FelipeLeonar2/Felipe_Leonardo_PLC4UNIT/Tarea 6/etiqueta.png

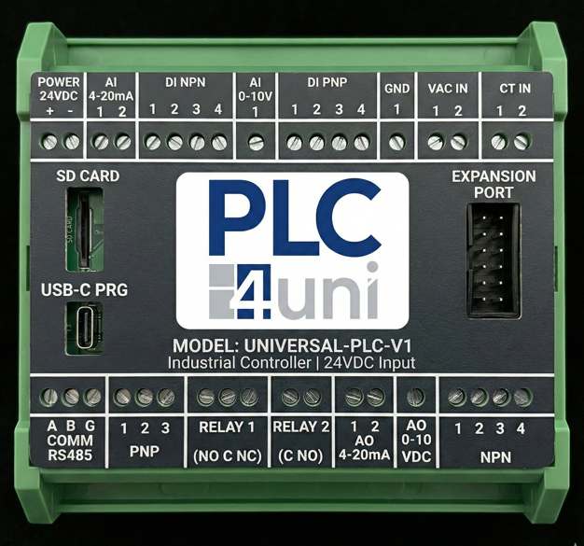
Tarea 6/etiqueta.png
