FelipeLeonar2/Felipe_Leonardo_PLC4UNIT/Tarea 6/Ensamble mejorado.FCStd

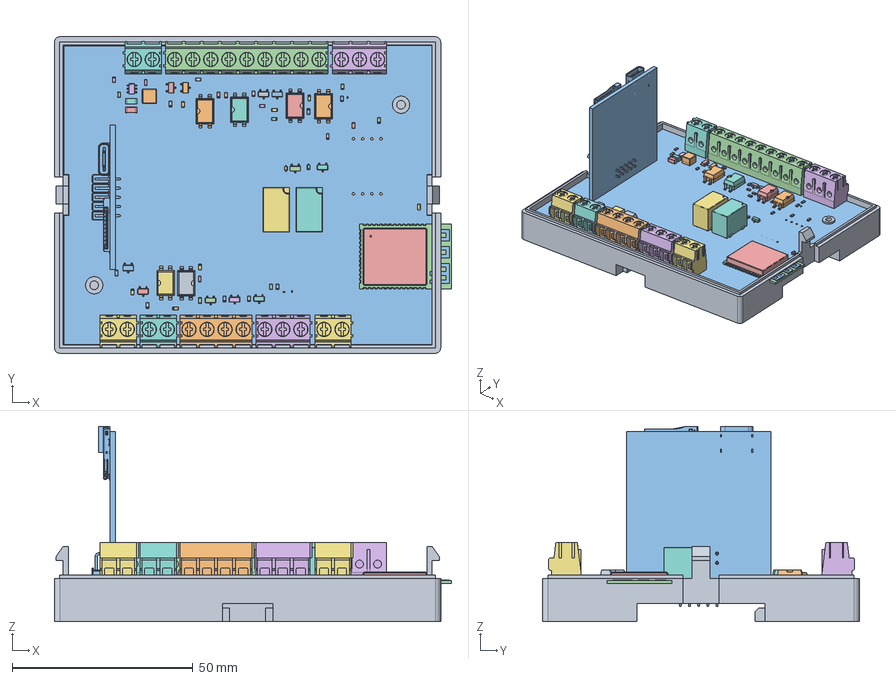
[picture p13: CAD file, 2025-12-11]
Tarea 6/Ensamble mejorado.FCStd
110.0 x 87.7 x 54.1 mm
Carcasa Inferior Felipe
PLC4UNIPCB1_001
Ensamble PCB Vertical1_001
R_0603_1608Metric027
R_0603_1608Metric028
SOT-030
SMDIP-4_W9.53mm006
D_SOD-525
R_0603_1608Metric029
L_APV_ANR4031
SOT-031
TerminalBlock_Phoenix_PT-1,5-9-5.0-H_1x09_P5.00mm_Horizontal001
SMDIP-4_W9.53mm007
C_0603_1608Metric003
C_0603_1608Metric004
TerminalBlock_Phoenix_PT-1,5-2-5.0-H_1x02_P5.00mm_Horizontal004
R_0603_1608Metric030
TerminalBlock_Phoenix_PT-1,5-4-5.0-H_1x04_P5.00mm_Horizontal001
R_0603_1608Metric031
SOT-032
SC-063
C_0201_0603Metric003
R_0603_1608Metric032
Relay_SPDT_Omron_G5V-003
R_0603_1608Metric033
R_0603_1608Metric034
ESP32-S3-WROOM-054
ESP32-S3-WROOM-055
ESP32-S3-WROOM-056
ESP32-S3-WROOM-057
ESP32-S3-WROOM-058
ESP32-S3-WROOM-059
ESP32-S3-WROOM-060
ESP32-S3-WROOM-061
ESP32-S3-WROOM-062
ESP32-S3-WROOM-063
ESP32-S3-WROOM-064
ESP32-S3-WROOM-065
ESP32-S3-WROOM-066
ESP32-S3-WROOM-067
ESP32-S3-WROOM-068
ESP32-S3-WROOM-069
ESP32-S3-WROOM-070
ESP32-S3-WROOM-071
ESP32-S3-WROOM-072
ESP32-S3-WROOM-073
ESP32-S3-WROOM-074
ESP32-S3-WROOM-075
ESP32-S3-WROOM-076
ESP32-S3-WROOM-077
ESP32-S3-WROOM-078
ESP32-S3-WROOM-079
ESP32-S3-WROOM-080
ESP32-S3-WROOM-081
ESP32-S3-WROOM-082
ESP32-S3-WROOM-083
ESP32-S3-WROOM-084
ESP32-S3-WROOM-085
ESP32-S3-WROOM-086
ESP32-S3-WROOM-087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
