FelipeLeonar2/Felipe_Leonardo_PLC4UNIT/Tarea 4/Ensamble PCB Vertical.STEP

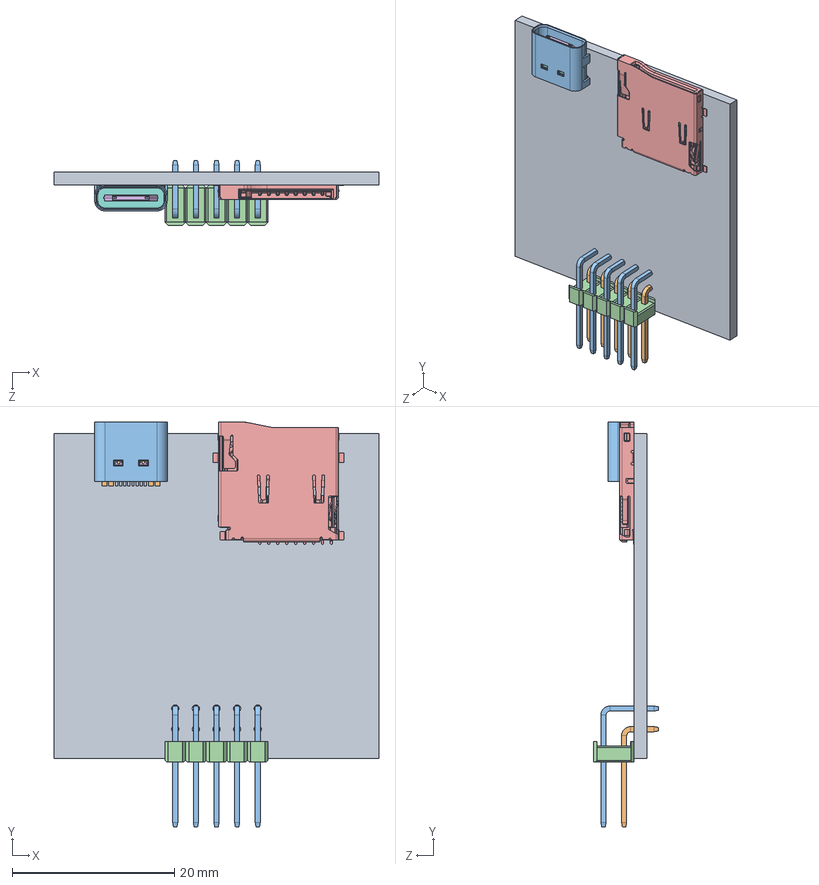
[picture p15: CAD file, 2025-12-04]
Tarea 4/Ensamble PCB Vertical.STEP
40.0 x 49.9 x 8.00 mm
PCB Vertical
2x5 Male Pin Header Angle
Same_Sky_MSD-4-A
USB Type C Port (SMD Type) (1)[1]
