FelipeLeonar2/Felipe_Leonardo_PLC4UNIT/Tarea 2/FreeCAD/Carcasa inferior 001 Felipe Leonardo 2021-1833.FCStd

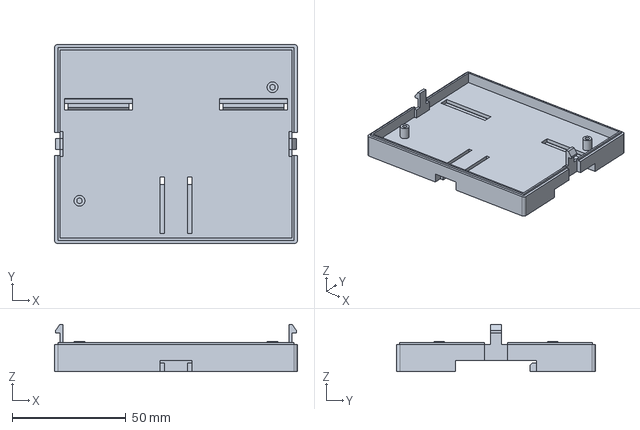
[picture p16: CAD file, 2025-10-09]
Tarea 2/FreeCAD/Carcasa inferior 001 Felipe Leonardo 2021-1833.FCStd
107.0 x 87.7 x 20.8 mm
