FelipeLeonar2/Felipe_Leonardo_PLC4UNIT/Tarea 3/2D ARCHIVO DXF/PLC4UNI-SUPERIOR-000.dxf

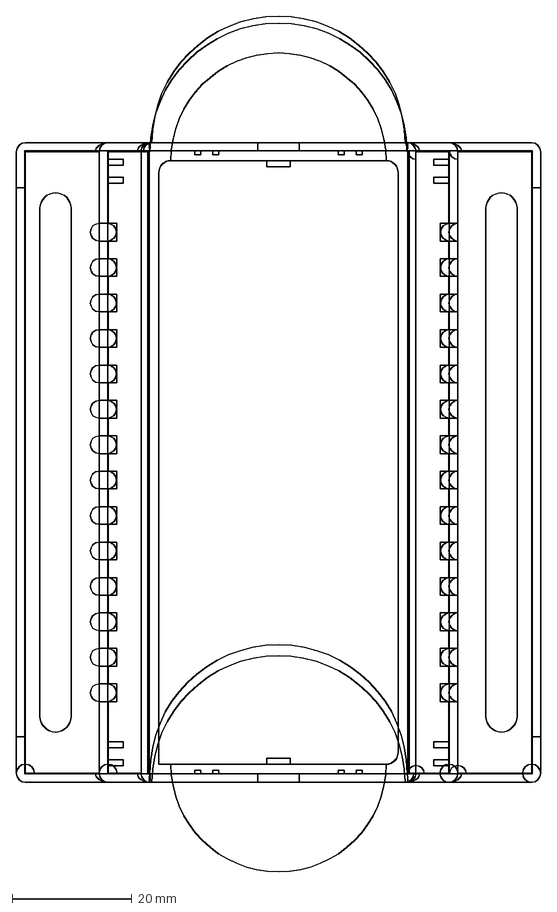
[picture p17: CAD file, 2025-10-10]
Tarea 3/2D ARCHIVO DXF/PLC4UNI-SUPERIOR-000.dxf
87.7 x 143.2 mm
