FelipeLeonar2/Felipe_Leonardo_PLC4UNIT/Tarea 4/2x5 Male Pin Header Angle.STEP

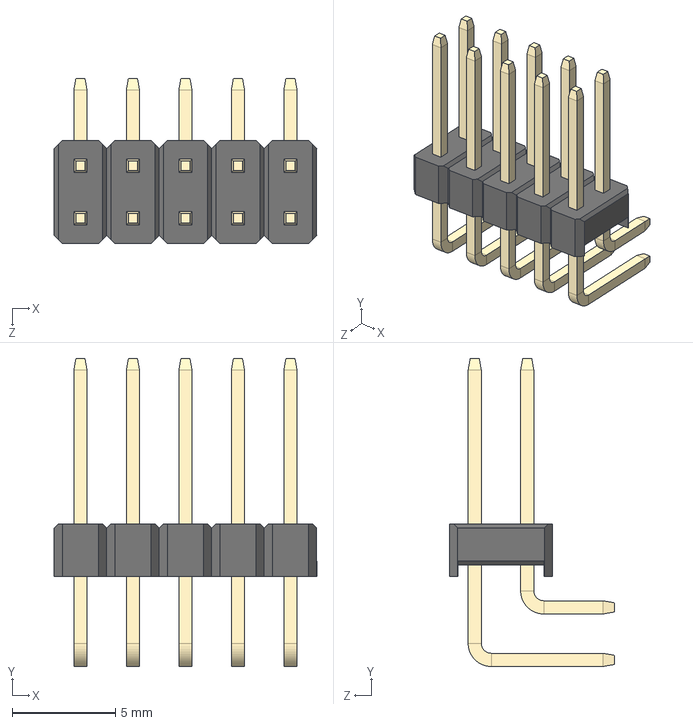
[picture p18: CAD file, 2025-12-04]
Tarea 4/2x5 Male Pin Header Angle.STEP
12.7 x 14.9 x 8.00 mm
