FelipeLeonar2/Felipe_Leonardo_PLC4UNIT/Tarea 2/FreeCAD/Carcasa Superor 000 Felipe Leonardo 2021-1833.FCStd

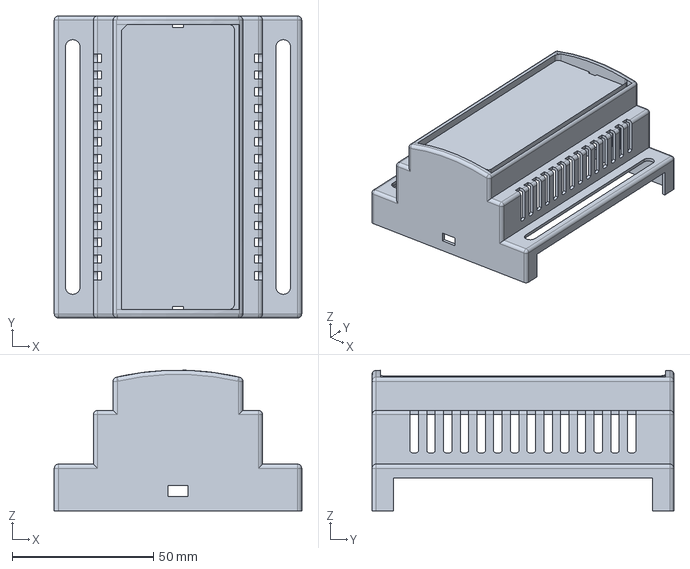
[picture p19: CAD file, 2025-10-09]
Tarea 2/FreeCAD/Carcasa Superor 000 Felipe Leonardo 2021-1833.FCStd
87.7 x 107.0 x 49.8 mm
