FelipeLeonar2/Felipe_Leonardo_PLC4UNIT/Tarea 3/2D ARCHIVO DXF/PLC4UNI-INFERIOR-001.dxf

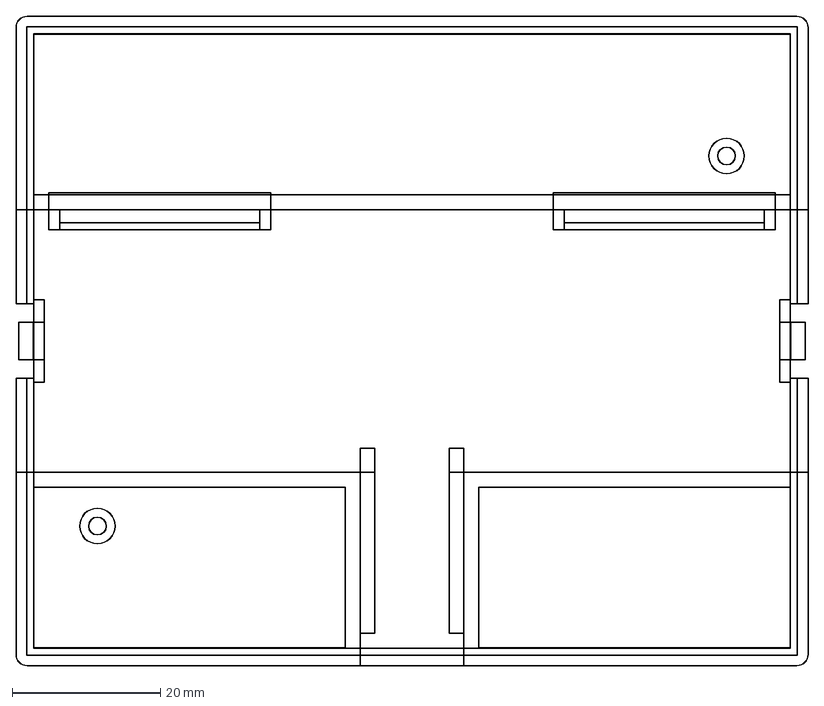
[picture p20: CAD file, 2025-10-10]
Tarea 3/2D ARCHIVO DXF/PLC4UNI-INFERIOR-001.dxf
107.0 x 87.7 mm
