FelipeLeonar2/Felipe_Leonardo_PLC4UNIT/Tarea 4/PCB Vertical.DXF

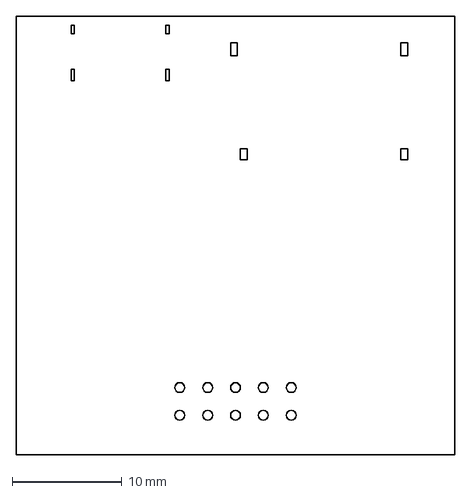
[picture p21: CAD file, 2025-12-04]
Tarea 4/PCB Vertical.DXF
40.0 x 40.0 mm
