FelipeLeonar2/Felipe_Leonardo_PLC4UNIT/Tarea 4/Same_Sky_MSD-4-A.step

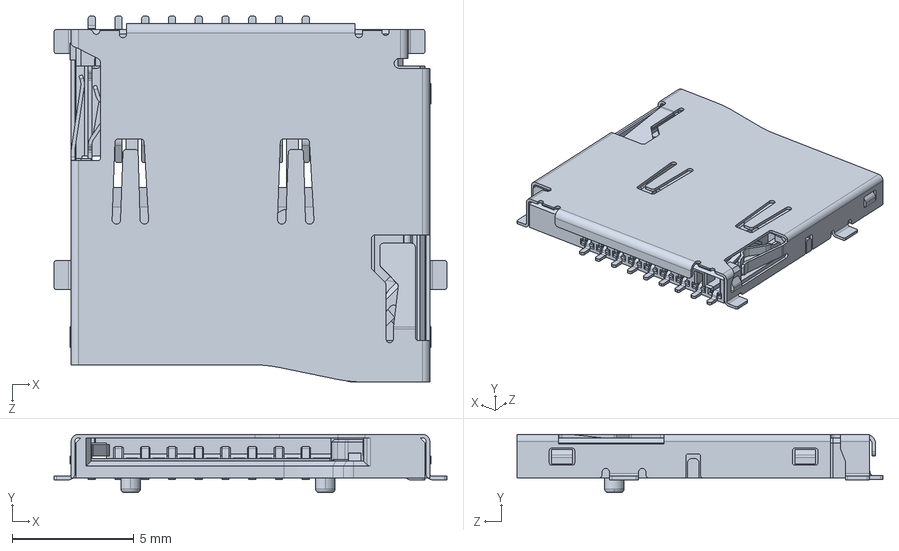
[picture p22: CAD file, 2025-12-04]
Tarea 4/Same_Sky_MSD-4-A.step
16.1 x 2.40 x 15.0 mm
