FelipeLeonar2/Felipe_Leonardo_PLC4UNIT/Tarea 4/USB Type C Port (SMD Type) (1)[1].STEP

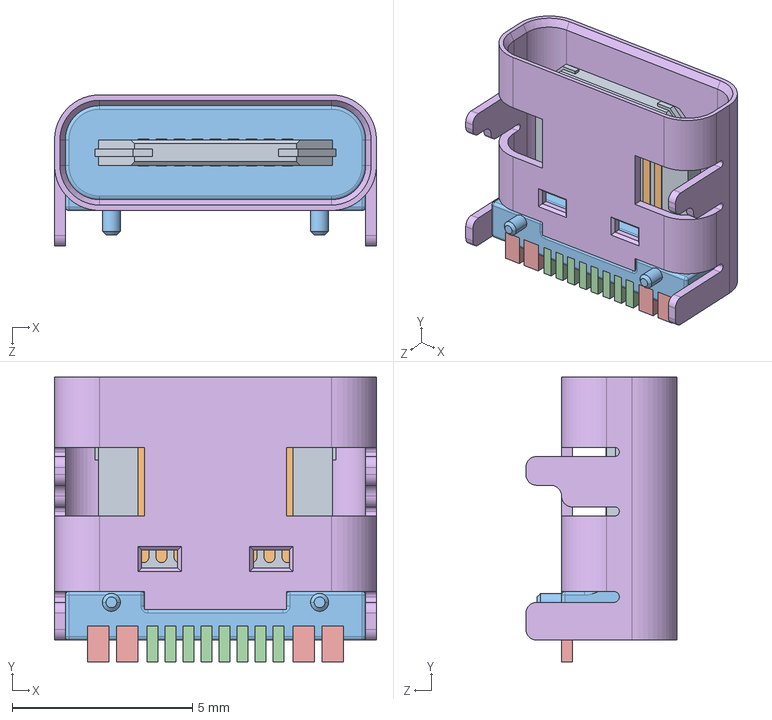
[picture p23: CAD file, 2025-12-04]
Tarea 4/USB Type C Port (SMD Type) (1)[1].STEP
8.94 x 7.90 x 4.20 mm
