FelipeLeonar2/Felipe_Leonardo_PLC4UNIT/PLC4Uni FelipeLG/PLC4Uni FelipeLG.kicad_pcb

## KiCad design PLC4Uni FelipeLG/PLC4Uni FelipeLG.kicad_pcb (2025-12-11)

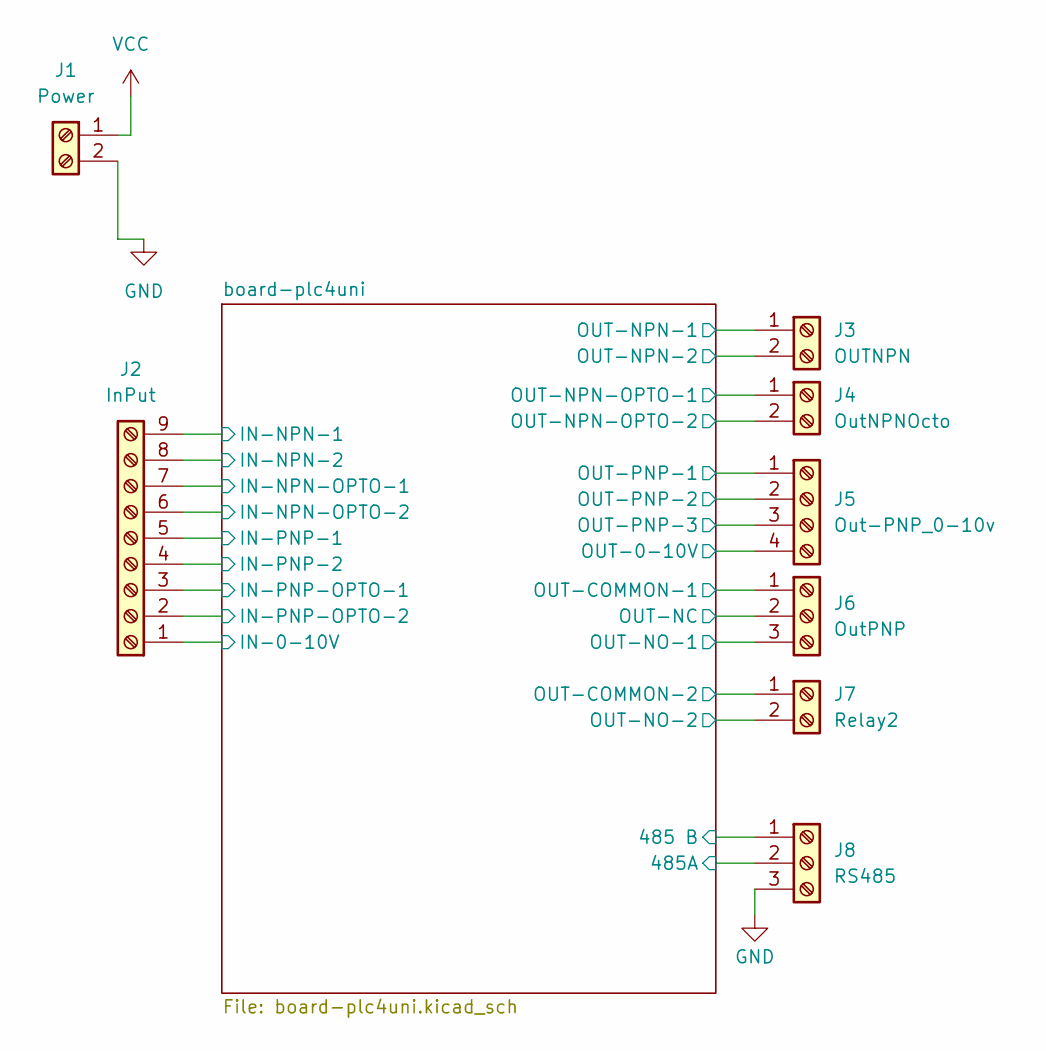
[picture p25: schematic PLC4Uni FelipeLG.kicad_sch]

Parts:
J1: Power; TerminalBlock_Phoenix_PT-1,5-2-5.0-H_1x02_P5.00mm_Horizontal
J2: InPut; TerminalBlock_Phoenix_PT-1,5-9-5.0-H_1x09_P5.00mm_Horizontal
J3: OUTNPN; TerminalBlock_Phoenix_PT-1,5-2-5.0-H_1x02_P5.00mm_Horizontal
J4: OutNPNOcto; TerminalBlock_Phoenix_PT-1,5-2-5.0-H_1x02_P5.00mm_Horizontal
J5: Out-PNP_0-10v; TerminalBlock_Phoenix_PT-1,5-4-5.0-H_1x04_P5.00mm_Horizontal
J6: OutPNP; TerminalBlock_Phoenix_PT-1,5-3-5.0-H_1x03_P5.00mm_Horizontal
J7: Relay2; TerminalBlock_Phoenix_PT-1,5-2-5.0-H_1x02_P5.00mm_Horizontal
J8: RS485; TerminalBlock_Phoenix_PT-1,5-3-5.0-H_1x03_P5.00mm_Horizontal

Connections:
/board-plc4uni/485 B: J8.1; also elsewhere on the board
/board-plc4uni/485A: J8.2; also elsewhere on the board
/board-plc4uni/IN-0-10V: J2.1; also elsewhere on the board
/board-plc4uni/IN-NPN-1: J2.9; also elsewhere on the board
/board-plc4uni/IN-NPN-2: J2.8; also elsewhere on the board
/board-plc4uni/IN-NPN-OPTO-1: J2.7; also elsewhere on the board
/board-plc4uni/IN-NPN-OPTO-2: J2.6; also elsewhere on the board
/board-plc4uni/IN-PNP-1: J2.5; also elsewhere on the board
/board-plc4uni/IN-PNP-2: J2.4; also elsewhere on the board
/board-plc4uni/IN-PNP-OPTO-1: J2.3; also elsewhere on the board
/board-plc4uni/IN-PNP-OPTO-2: J2.2; also elsewhere on the board
/board-plc4uni/OUT-0-10V: J5.4; also elsewhere on the board
/board-plc4uni/OUT-COMMON-1: J6.1; also elsewhere on the board
/board-plc4uni/OUT-COMMON-2: J7.1; also elsewhere on the board
/board-plc4uni/OUT-NC: J6.2; also elsewhere on the board
/board-plc4uni/OUT-NO-1: J6.3; also elsewhere on the board
/board-plc4uni/OUT-NO-2: J7.2; also elsewhere on the board
/board-plc4uni/OUT-NPN-1: J3.1; also elsewhere on the board
/board-plc4uni/OUT-NPN-2: J3.2; also elsewhere on the board
/board-plc4uni/OUT-NPN-OPTO-1: J4.1; also elsewhere on the board
/board-plc4uni/OUT-NPN-OPTO-2: J4.2; also elsewhere on the board
/board-plc4uni/OUT-PNP-1: J5.1; also elsewhere on the board
/board-plc4uni/OUT-PNP-2: J5.2; also elsewhere on the board
/board-plc4uni/OUT-PNP-3: J5.3; also elsewhere on the board
GND: J1.2, J8.3; also elsewhere on the board
VCC: J1.1; also elsewhere on the board

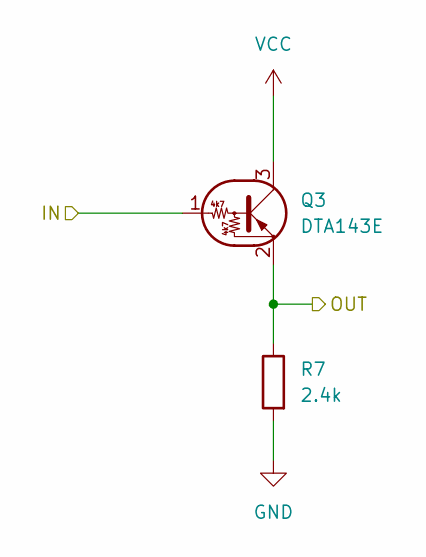
[picture p26: schematic OUT-NPN-1.kicad_sch]

Parts:
Q3: DTA143E; SC-59
R7: 2.4k; R_0603_1608Metric

Connections:
/board-plc4uni/OUT-NPN-2: Q3.2 (E), R7.2; also elsewhere on the board
/board-plc4uni/OUT-NPN-2/IN: Q3.1 (B); also elsewhere on the board
GND: R7.1; also elsewhere on the board
VCC: Q3.3 (C); also elsewhere on the board

Parts of its further copies:
Q7: DTA143E; SC-59
R21: 2.4k; R_0603_1608Metric

Connections of its further copies:
/board-plc4uni/OUT-NPN-1: Q7.2 (E), R21.2; also elsewhere on the board
/board-plc4uni/OUT-NPN-1/IN: Q7.1 (B); also elsewhere on the board
GND: R21.1; also elsewhere on the board
VCC: Q7.3 (C); also elsewhere on the board

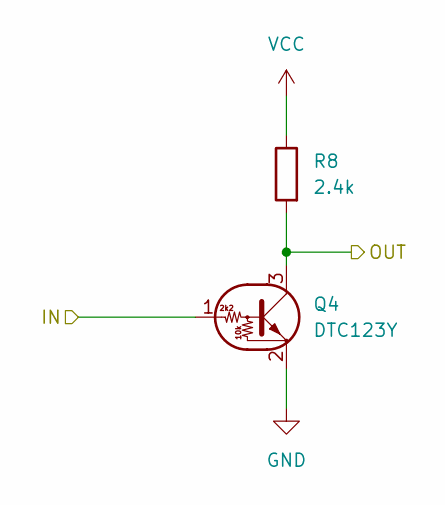
[picture p27: schematic output-pnp.kicad_sch]

Parts:
Q4: DTC123Y; SOT-23
R8: 2.4k; R_0603_1608Metric

Connections:
/board-plc4uni/OUT-PNP-1: Q4.3 (C), R8.1; also elsewhere on the board
/board-plc4uni/output-pnp-1/IN: Q4.1 (B); also elsewhere on the board
GND: Q4.2 (E); also elsewhere on the board
VCC: R8.2; also elsewhere on the board

Parts of its further copies:
Q8, Q9: DTC123Y; SOT-23
R22, R23: 2.4k; R_0603_1608Metric

Connections of its further copies:
/board-plc4uni/OUT-PNP-2: Q8.3 (C), R22.1; also elsewhere on the board
/board-plc4uni/OUT-PNP-3: Q9.3 (C), R23.1; also elsewhere on the board
/board-plc4uni/output-pnp-2/IN: Q8.1 (B); also elsewhere on the board
/board-plc4uni/output-pnp-3/IN: Q9.1 (B); also elsewhere on the board
GND: Q8.2 (E), Q9.2 (E); also elsewhere on the board
VCC: R22.2, R23.2; also elsewhere on the board

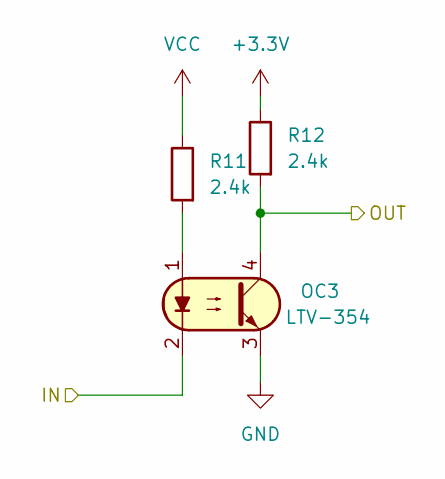
[picture p28: schematic input-pnp-opto.kicad_sch]

Parts:
OC3: FOD817S; SMDIP-4_W9.53mm; Part Number LTV-354
R11, R12: 2.4k; R_0603_1608Metric

Connections:
+3.3V: R12.2; also elsewhere on the board
/board-plc4uni/IN-PNP-OPTO-1: OC3.2; also elsewhere on the board
/board-plc4uni/input-pnp-opto-1/OUT: OC3.4, R12.1; also elsewhere on the board
GND: OC3.3; also elsewhere on the board
unnamed: OC3.1, R11.1
VCC: R11.2; also elsewhere on the board

Parts of its further copies:
OC5: FOD817S; SMDIP-4_W9.53mm; Part Number LTV-354
R16, R17: 2.4k; R_0603_1608Metric

Connections of its further copies:
+3.3V: R17.2; also elsewhere on the board
/board-plc4uni/IN-PNP-OPTO-2: OC5.2; also elsewhere on the board
/board-plc4uni/input-pnp-opto-2/OUT: OC5.4, R17.1; also elsewhere on the board
GND: OC5.3; also elsewhere on the board
unnamed: OC5.1, R16.1
VCC: R16.2; also elsewhere on the board

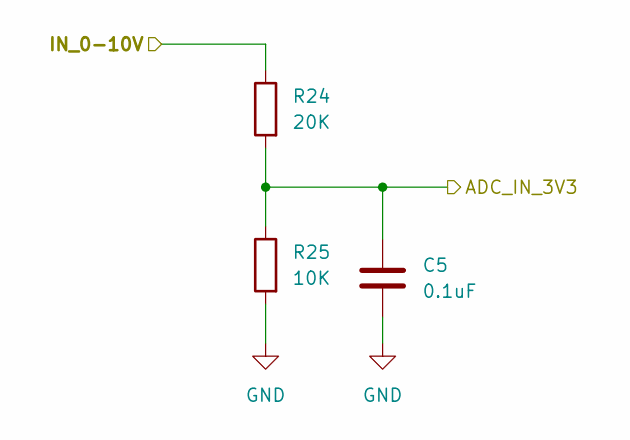
[picture p29: schematic INPUT-0-10V.kicad_sch]

Parts:
C5: 0.1uF; C_0201_0603Metric; LCSC C66501
R24: 20K; R_0603_1608Metric
R25: 10K; R_0603_1608Metric

Connections:
/board-plc4uni/IN-0-10V: R24.2; also elsewhere on the board
/board-plc4uni/INPUT-0-10V/ADC_IN_3V3: C5.2, R24.1, R25.2; also elsewhere on the board
GND: C5.1, R25.1; also elsewhere on the board

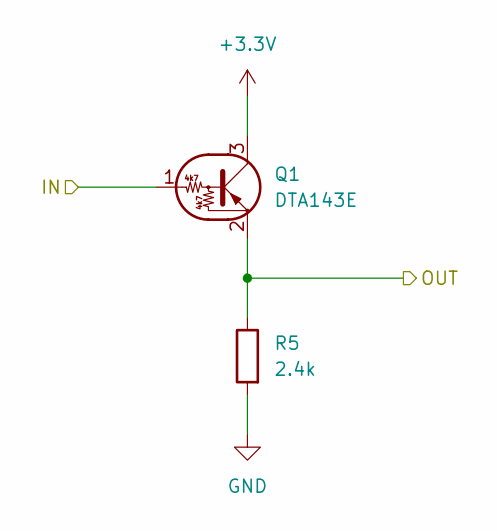
[picture p30: schematic input-npn.kicad_sch]

Parts:
Q1: DTA143E; SC-59
R5: 2.4k; R_0603_1608Metric

Connections:
+3.3V: Q1.3 (C); also elsewhere on the board
/board-plc4uni/IN-NPN-1: Q1.1 (B); also elsewhere on the board
/board-plc4uni/input-npn-1/OUT: Q1.2 (E), R5.2; also elsewhere on the board
GND: R5.1; also elsewhere on the board

Parts of its further copies:
Q5: DTA143E; SC-59
R15: 2.4k; R_0603_1608Metric

Connections of its further copies:
+3.3V: Q5.3 (C); also elsewhere on the board
/board-plc4uni/IN-NPN-2: Q5.1 (B); also elsewhere on the board
/board-plc4uni/input-npn-2/OUT: Q5.2 (E), R15.2; also elsewhere on the board
GND: R15.1; also elsewhere on the board

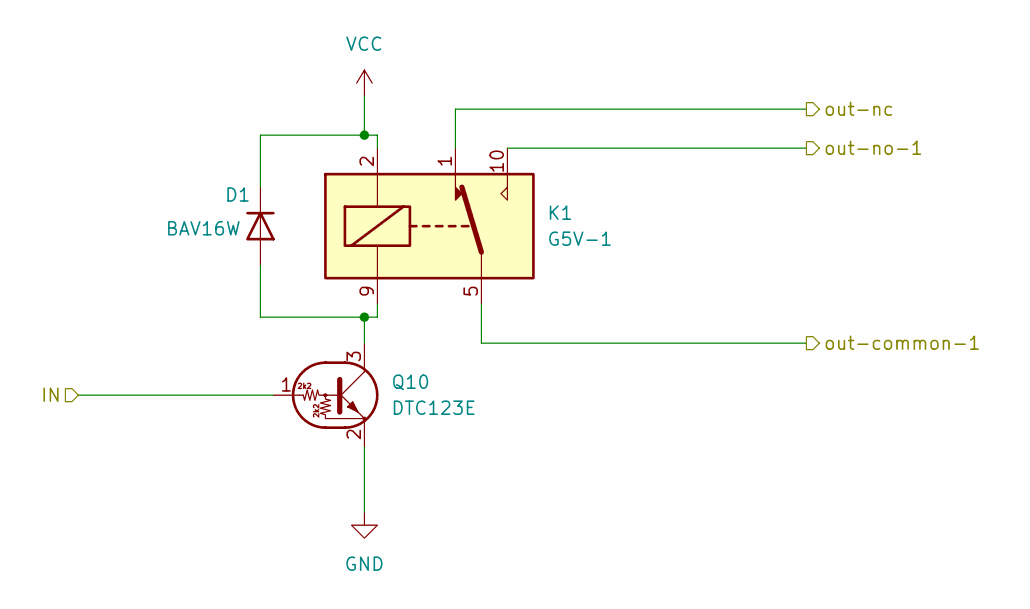
[picture p31: schematic OUT-RELAY-1.kicad_sch]

Parts:
D1: 1N4148WT; D_SOD-523; Part number BAV16W
K1: G5V-1; Relay_SPDT_Omron_G5V-1
Q10: DTC123E; SOT-23

Connections:
/board-plc4uni/OUT-COMMON-1: K1.5, K1.6; also elsewhere on the board
/board-plc4uni/OUT-NC: K1.1; also elsewhere on the board
/board-plc4uni/OUT-NO-1: K1.10; also elsewhere on the board
/board-plc4uni/OUT-RELAY-1/IN: Q10.1 (B); also elsewhere on the board
GND: Q10.2 (E); also elsewhere on the board
unnamed: D1.2 (A), K1.9, Q10.3 (C)
VCC: D1.1 (K), K1.2; also elsewhere on the board

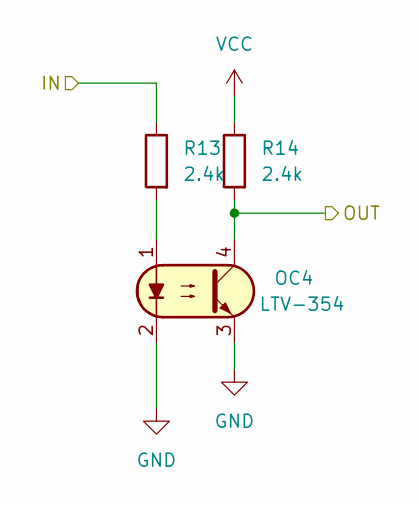
[picture p32: schematic output-npn-opto.kicad_sch]

Parts:
OC4: FOD817S; SMDIP-4_W9.53mm; Part Number LTV-354
R13, R14: 2.4k; R_0603_1608Metric

Connections:
/board-plc4uni/OUT-NPN-OPTO-1: OC4.4, R14.1; also elsewhere on the board
/board-plc4uni/output-npn-opto-1/IN: R13.2; also elsewhere on the board
GND: OC4.2, OC4.3; also elsewhere on the board
unnamed: OC4.1, R13.1
VCC: R14.2; also elsewhere on the board

Parts of its further copies:
OC6: FOD817S; SMDIP-4_W9.53mm; Part Number LTV-354
R19, R20: 2.4k; R_0603_1608Metric

Connections of its further copies:
/board-plc4uni/OUT-NPN-OPTO-2: OC6.4, R20.1; also elsewhere on the board
/board-plc4uni/output-npn-opto-2/IN: R19.2; also elsewhere on the board
GND: OC6.2, OC6.3; also elsewhere on the board
unnamed: OC6.1, R19.1
VCC: R20.2; also elsewhere on the board

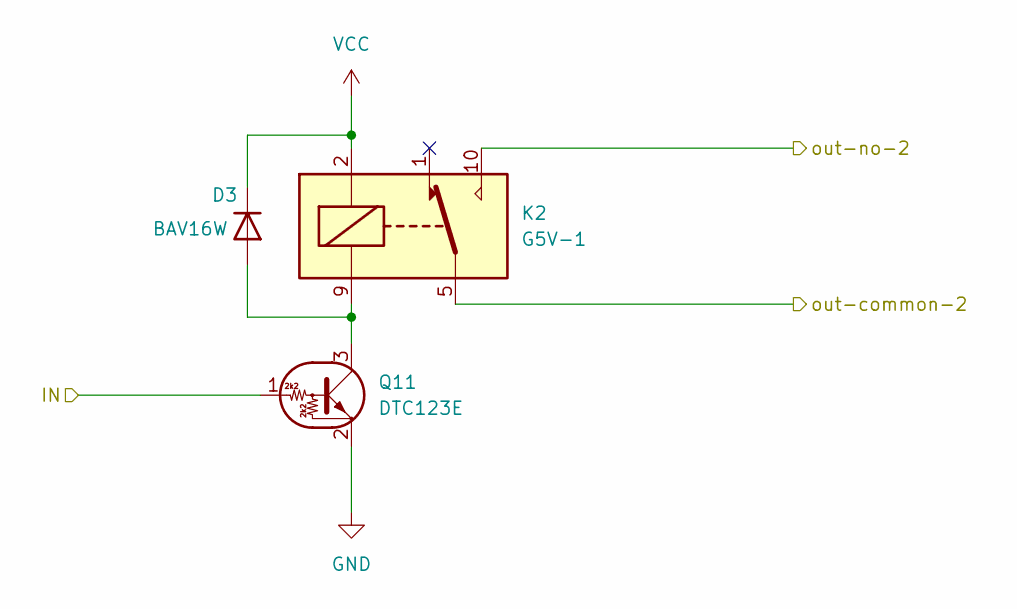
[picture p33: schematic OUT-RELAY-2.kicad_sch]

Parts:
D3: 1N4148WT; D_SOD-523; Part number BAV16W
K2: G5V-1; Relay_SPDT_Omron_G5V-1
Q11: DTC123E; SOT-23

Connections:
/board-plc4uni/OUT-COMMON-2: K2.5, K2.6; also elsewhere on the board
/board-plc4uni/OUT-NO-2: K2.10; also elsewhere on the board
/board-plc4uni/OUT-RELAY-2/IN: Q11.1 (B); also elsewhere on the board
GND: Q11.2 (E); also elsewhere on the board
unnamed: D3.2 (A), K2.9, Q11.3 (C)
VCC: D3.1 (K), K2.2; also elsewhere on the board

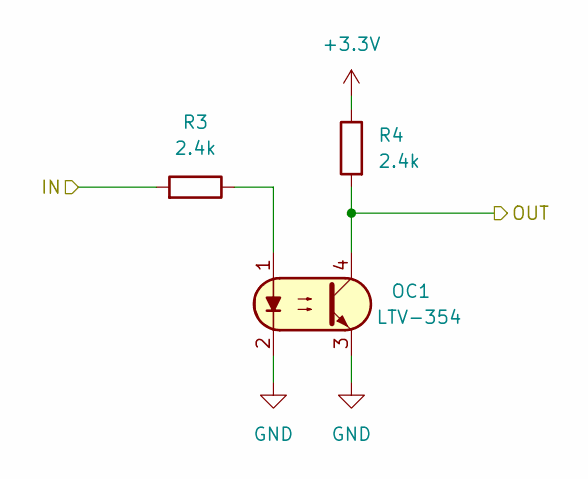
[picture p34: schematic input-npn-opto.kicad_sch]

Parts:
OC1: FOD817S; SMDIP-4_W9.53mm; Part Number LTV-354
R3, R4: 2.4k; R_0603_1608Metric

Connections:
+3.3V: R4.2; also elsewhere on the board
/board-plc4uni/IN-NPN-OPTO-2: R3.1; also elsewhere on the board
/board-plc4uni/input-npn-opto-2/OUT: OC1.4, R4.1; also elsewhere on the board
GND: OC1.2, OC1.3; also elsewhere on the board
unnamed: OC1.1, R3.2

Parts of its further copies:
OC2: FOD817S; SMDIP-4_W9.53mm; Part Number LTV-354
R9, R10: 2.4k; R_0603_1608Metric

Connections of its further copies:
+3.3V: R10.2; also elsewhere on the board
/board-plc4uni/IN-NPN-OPTO-1: R9.1; also elsewhere on the board
/board-plc4uni/input-npn-opto-1/OUT: OC2.4, R10.1; also elsewhere on the board
GND: OC2.2, OC2.3; also elsewhere on the board
unnamed: OC2.1, R9.2

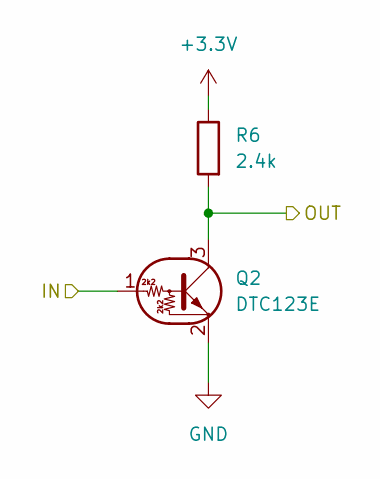
[picture p35: schematic input-pnp.kicad_sch]

Parts:
Q2: DTC123E; SOT-23
R6: 2.4k; R_0603_1608Metric

Connections:
+3.3V: R6.2; also elsewhere on the board
/board-plc4uni/IN-PNP-1: Q2.1 (B); also elsewhere on the board
/board-plc4uni/input-pnp-1/OUT: Q2.3 (C), R6.1; also elsewhere on the board
GND: Q2.2 (E); also elsewhere on the board

Parts of its further copies:
Q6: DTC123E; SOT-23
R18: 2.4k; R_0603_1608Metric

Connections of its further copies:
+3.3V: R18.2; also elsewhere on the board
/board-plc4uni/IN-PNP-2: Q6.1 (B); also elsewhere on the board
/board-plc4uni/input-pnp-2/OUT: Q6.3 (C), R18.1; also elsewhere on the board
GND: Q6.2 (E); also elsewhere on the board

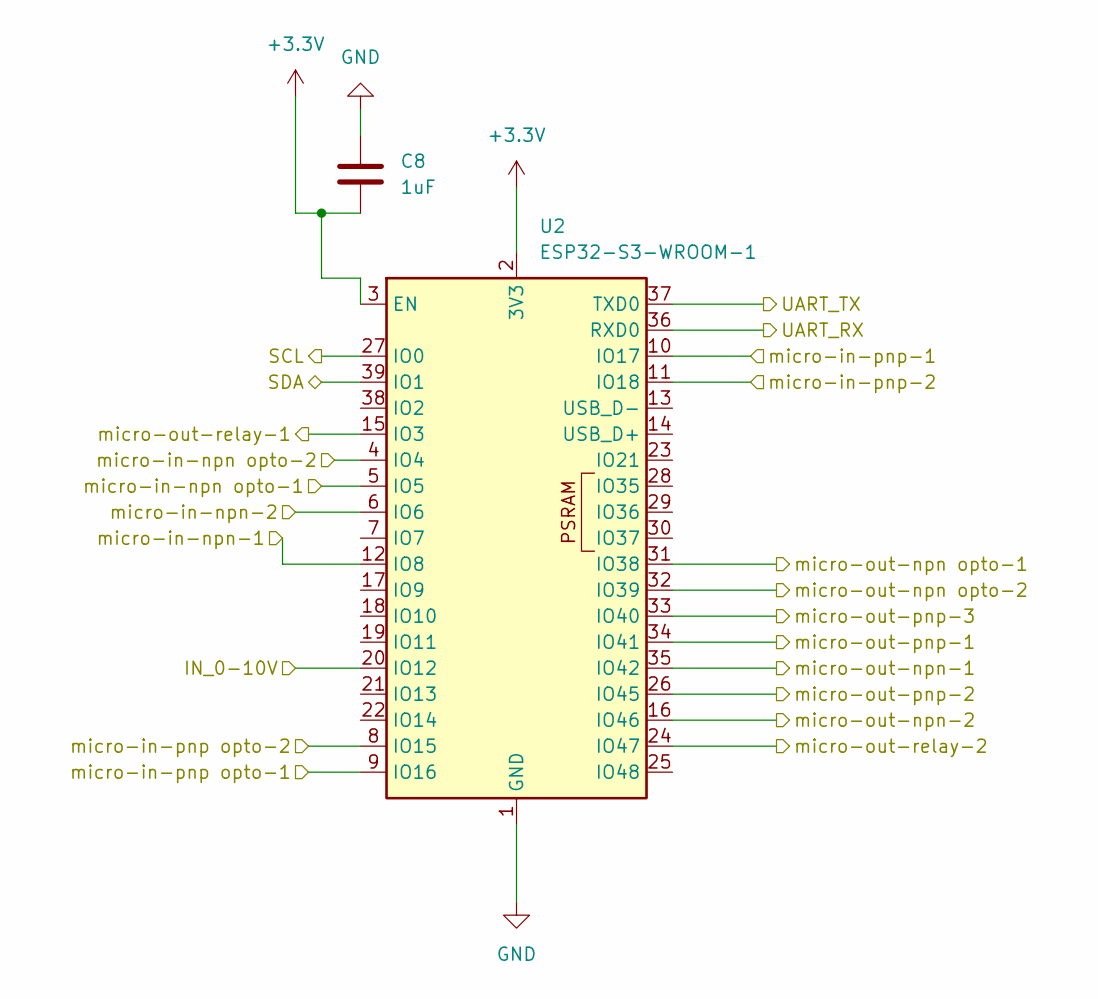
[picture p36: schematic plc4uni-cpu.kicad_sch]

Parts:
C8: 1uF; C_0603_1608Metric; LCSC C89632
U2: ESP32-S3-WROOM-1

Connections:
+3.3V: C8.2, U2.2 (3V3), U2.3 (EN); also elsewhere on the board
/board-plc4uni/INPUT-0-10V/ADC_IN_3V3: U2.20 (IO12); also elsewhere on the board
/board-plc4uni/OUT-NPN-1/IN: U2.35 (IO42); also elsewhere on the board
/board-plc4uni/OUT-NPN-2/IN: U2.16 (IO46); also elsewhere on the board
/board-plc4uni/OUT-RELAY-1/IN: U2.15 (IO3); also elsewhere on the board
/board-plc4uni/OUT-RELAY-2/IN: U2.24 (IO47); also elsewhere on the board
/board-plc4uni/OUTPUT-0-10V/SCL: U2.27 (IO0); also elsewhere on the board
/board-plc4uni/OUTPUT-0-10V/SDA: U2.39 (IO1); also elsewhere on the board
/board-plc4uni/RS485/UART_RX: U2.36 (RXD0); also elsewhere on the board
/board-plc4uni/RS485/UART_TX: U2.37 (TXD0); also elsewhere on the board
/board-plc4uni/input-npn-1/OUT: U2.12 (IO8); also elsewhere on the board
/board-plc4uni/input-npn-2/OUT: U2.6 (IO6); also elsewhere on the board
/board-plc4uni/input-npn-opto-1/OUT: U2.5 (IO5); also elsewhere on the board
/board-plc4uni/input-npn-opto-2/OUT: U2.4 (IO4); also elsewhere on the board
/board-plc4uni/input-pnp-1/OUT: U2.10 (IO17); also elsewhere on the board
/board-plc4uni/input-pnp-2/OUT: U2.11 (IO18); also elsewhere on the board
/board-plc4uni/input-pnp-opto-1/OUT: U2.9 (IO16); also elsewhere on the board
/board-plc4uni/input-pnp-opto-2/OUT: U2.8 (IO15); also elsewhere on the board
/board-plc4uni/output-npn-opto-1/IN: U2.31 (IO38); also elsewhere on the board
/board-plc4uni/output-npn-opto-2/IN: U2.32 (IO39); also elsewhere on the board
/board-plc4uni/output-pnp-1/IN: U2.34 (IO41); also elsewhere on the board
/board-plc4uni/output-pnp-2/IN: U2.26 (IO45); also elsewhere on the board
/board-plc4uni/output-pnp-3/IN: U2.33 (IO40); also elsewhere on the board
GND: C8.1, U2.1 (GND), U2.40 (GND), U2.41 (GND); also elsewhere on the board

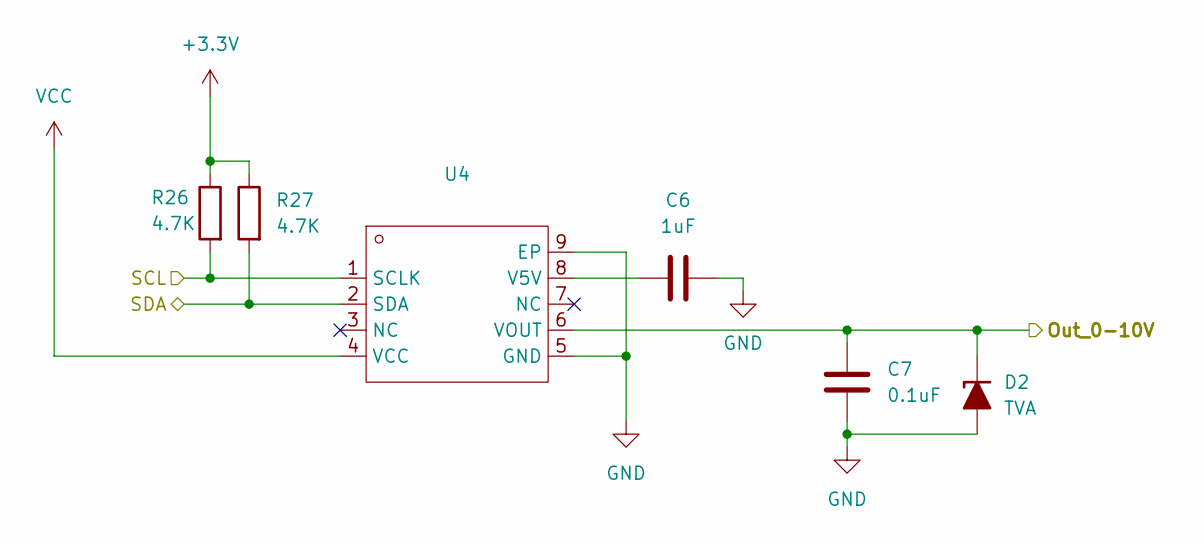
[picture p37: schematic OUTPUT-0-10V.kicad_sch]

Parts:
C6: 1uF; C_0201_0603Metric; LCSC C1592
C7: 0.1uF; C_0201_0603Metric; LCSC C66501
D2: TVA; D_0201_0603Metric_TVS; LCSC C18199535
R26, R27: 4.7K; R_0603_1608Metric
U4: Sensirion_DFN-8-1EP_2.5x2.5mm_P0.5mm_EP1.1x1.7mm; LCSC C3152008

Connections:
+3.3V: R26.2, R27.2; also elsewhere on the board
/board-plc4uni/OUT-0-10V: C7.2, D2.1 (K), U4.6 (VOUT); also elsewhere on the board
/board-plc4uni/OUTPUT-0-10V/SCL: R26.1, U4.1 (SCLK); also elsewhere on the board
/board-plc4uni/OUTPUT-0-10V/SDA: R27.1, U4.2 (SDA); also elsewhere on the board
GND: C6.2, C7.1, D2.2 (A), U4.5 (GND), U4.9 (EP); also elsewhere on the board
unnamed: C6.1, U4.8 (V5V)
VCC: U4.4 (VCC); also elsewhere on the board

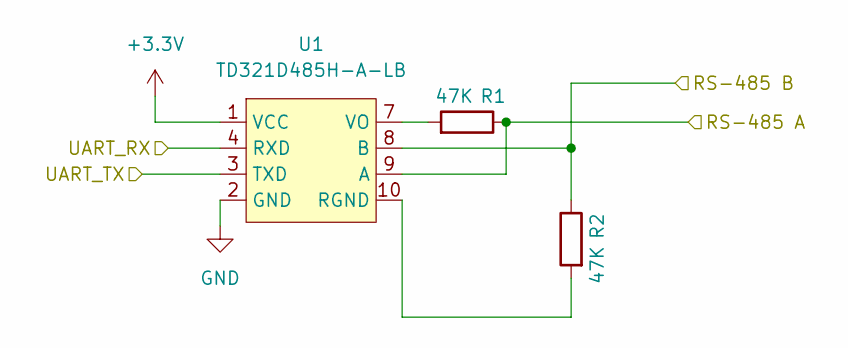
[picture p38: schematic RS485.kicad_sch]

Parts:
R1, R2: 47K; R_0603_1608Metric
U1: TD321D485H-A-LB; TD321D48H-A

Connections:
+3.3V: U1.1 (VCC); also elsewhere on the board
/board-plc4uni/485 B: R2.2, U1.8 (B); also elsewhere on the board
/board-plc4uni/485A: R1.2, U1.9 (A); also elsewhere on the board
/board-plc4uni/RS485/UART_RX: U1.4 (RXD); also elsewhere on the board
/board-plc4uni/RS485/UART_TX: U1.3 (TXD); also elsewhere on the board
GND: U1.2 (GND); also elsewhere on the board
unnamed: R2.1, U1.10 (RGND)
unnamed: R1.1, U1.7 (VO)

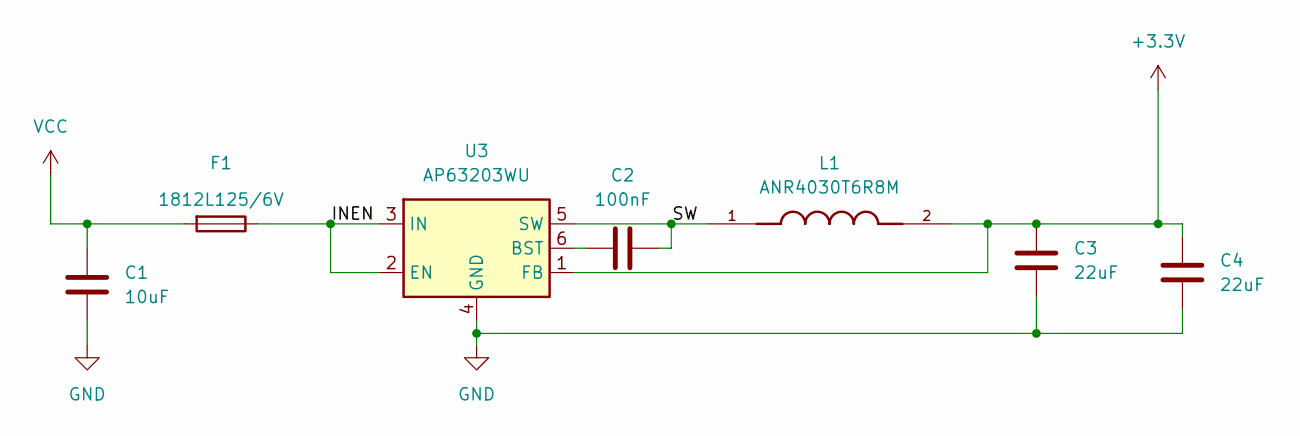
[picture p39: schematic source protection.kicad_sch]

Parts:
C1: 10uF; C_0603_1608Metric; LCSC C89632
C2: 100nF; C_0603_1608Metric; LCSC C519980
C3, C4: 22uF; C_1206_3216Metric; LCSC C7472972
F1: Fuse; Fuse_0603_1608Metric; Part number 1812L125/6V
L1: ANR4030T6R8M; L_APV_ANR4030; LCSC C77758
U3: AP63203WU; TSOT-23-6

Connections:
+3.3V: C3.1, C4.1, L1.2, U3.1 (FB); also elsewhere on the board
/board-plc4uni/source protection/INEN: F1.1, U3.2 (EN), U3.3 (IN)
/board-plc4uni/source protection/SW: C2.2, L1.1, U3.5 (SW)
GND: C1.2, C3.2, C4.2, U3.4 (GND); also elsewhere on the board
unnamed: C2.1, U3.6 (BST)
VCC: C1.1, F1.2; also elsewhere on the board

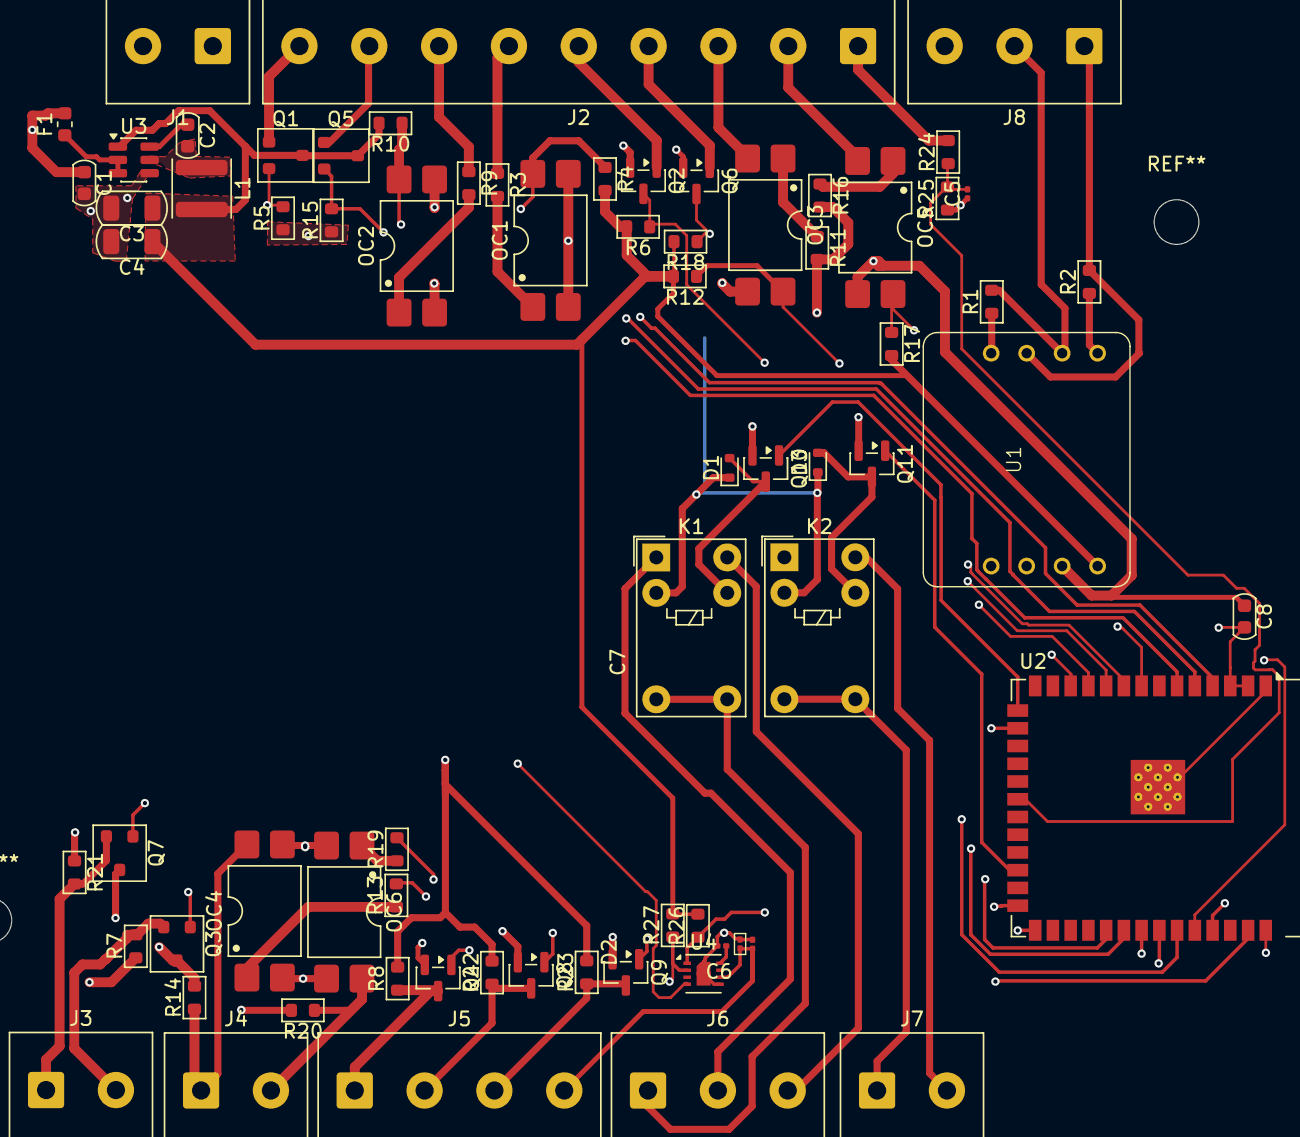
[picture p40: board PLC4Uni FelipeLG.kicad_pcb from above]

Board: 4 copper layers, 71 parts (0 on the bottom side), 63 nets.
