FelipeLeonar2/Felipe_Leonardo_PLC4UNIT/(commit log)

2025-10-06 Diseños 3D de la carcasa para el PLC
2025-10-09 Tarea 2
    [Carcasa Superor 000 Felipe Leonardo 2021-1833.FCStd, Carcasa inferior 001 Felipe Leonardo 2021-1833.FCStd]
2025-10-10 Tarea 3 agregada
    [PLC4UNI-INFERIOR-001.dxf, PLC4UNI-SUPERIOR-000.dxf, PLC4uni.kicad_pcb, PLC4uni.kicad_sch]
2025-11-20 Add files via upload
    Se agregaron los circuitos del PLC
    [INPUT-0-10V.kicad_sch, OUT-NPN-1.kicad_sch, OUT-RELAY-1.kicad_sch, OUT-RELAY-2.kicad_sch, OUTPUT-0-10V.kicad_sch, PLC4Uni FelipeLG.kicad_pcb, PLC4Uni FelipeLG.kicad_sch, RS485.kicad_sch]
2025-12-04 Add files via upload
    Updated Circuitos corregidos y pistas agregadas
    [INPUT-0-10V.kicad_sch, OUT-NPN-1.kicad_sch, OUT-RELAY-1.kicad_sch, OUT-RELAY-2.kicad_sch, OUTPUT-0-10V.kicad_sch, PLC4Uni FelipeLG.kicad_sch, RS485.kicad_sch, board-plc4uni.kicad_sch]
